asinclado/lingxiao-pump-rs485/docs/rs485-adapter-back.jpg

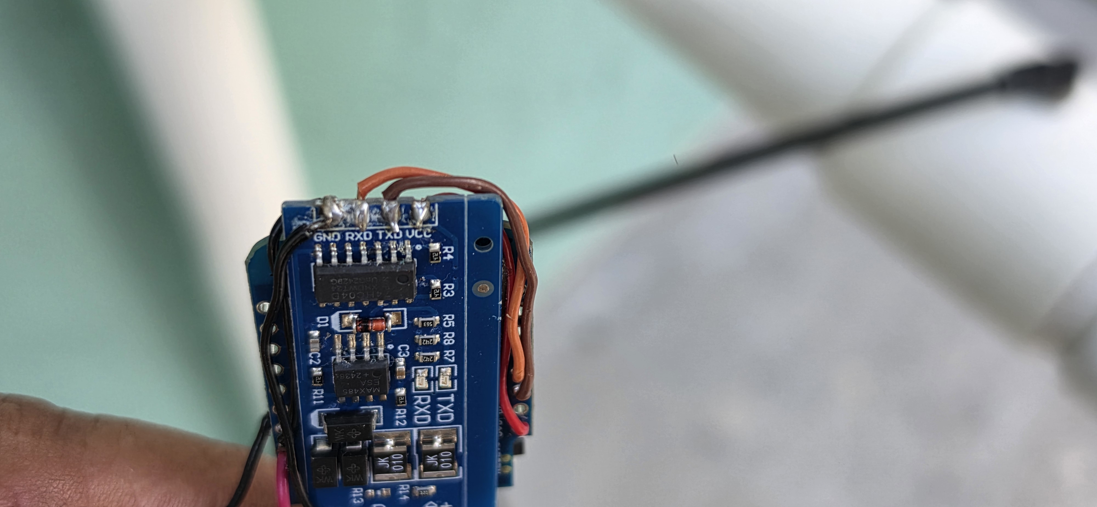
docs/rs485-adapter-back.jpg
