asinclado/lingxiao-pump-rs485/(commit log)

2026-09-19 Initial commit: Lingxiao Relaax220-VS RS485 pump controller
2026-09-19 Note pump reported power is inaccurate (reads high); use separate power monitor
2026-09-19 Clarify pump connector is male M16 4-pin (needs female mating cable)
2026-09-19 Update project status: original pump failed, replaced with same model; sketch not yet working on it
2026-09-19 Correct wire colors to conventional: Yellow=A, Green=B, Red=5V, Black=GND
2026-09-19 Disclaimer: any damage to the pump from attempting this is at your own risk
2026-09-19 Identify actual hardware (Wemos D1 Mini, MAX485 auto-direction module); add board photos; fix TTL wiring labels (RXD/TXD)
2026-09-19 Update connection diagram to match real hardware (Wemos D1 Mini, MAX485 module A+/B-, RXD/TXD, pump-powered)
2026-09-19 Match actual wiring: module TXD->D7, RXD->D6 (label-to-label on this module)
2026-09-19 Wiring per sketch: D6->RXD, D7->TXD (SoftwareSerial(D6,D7), RO->D6, DI->D7)
2026-09-19 Fix ESP8266 crash: addToLog no longer rebuilds log String every line (lazy buildLogText); keep Advanced log panel open
    [LingxiaoPumpRS485.ino]
2026-09-19 Update project status: working on Lingxiao Relaax220-VS; remove pump-failure note
2026-09-19 Correct pump model to Lingxiao SFP220-VS
2026-09-19 Sync sketch: separate /log page (crash fix), log caps, Local Release + extra speeds/flow/mode/program commands
    [LingxiaoPumpRS485.ino]
2026-09-19 Reported power accuracy varies by unit (current accurate, earlier read high)
2026-09-19 Revert reported-power note to original wording
